KMDE-10/ghra/hardware/images/WhatsApp Image 2026-03-20 at 16.06.54 (3).jpeg

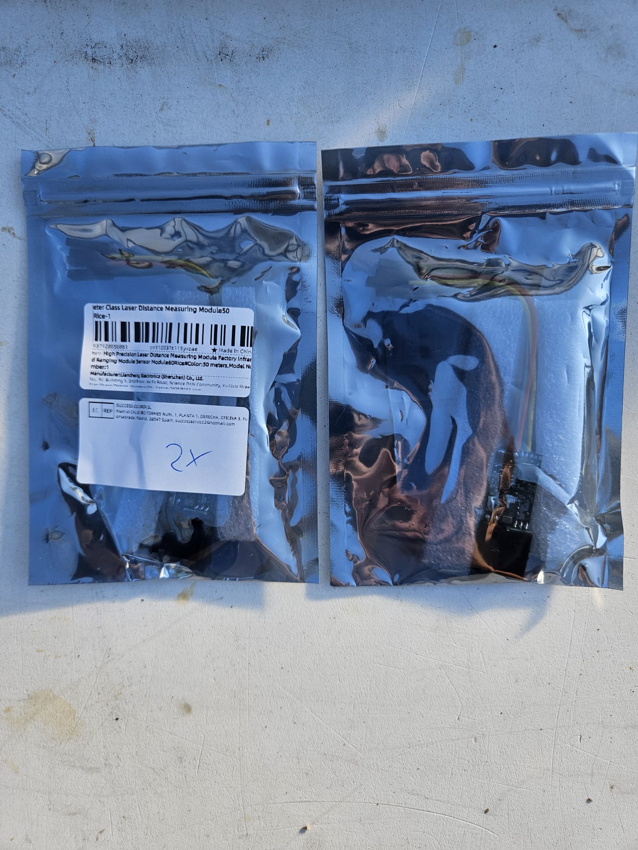
hardware/images/WhatsApp Image 2026-03-20 at 16.06.54 (3).jpeg
