KMDE-10/ghra/hardware/inverter/WhatsApp Image 2026-03-28 at 12.23.41(1).jpeg

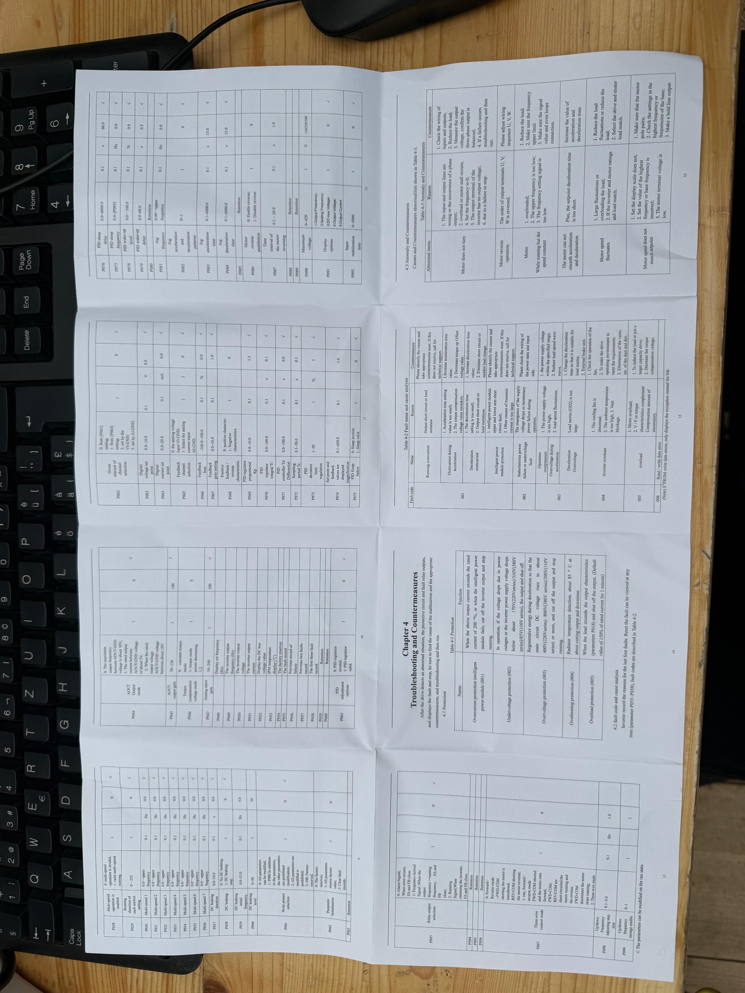
hardware/inverter/WhatsApp Image 2026-03-28 at 12.23.41(1).jpeg
