KMDE-10/ghra/hardware/20260308_Budget-Suspension Structure - Budget 09.03.2026.csv

Item | Link | Quantity | Cost w/o VAT | Supplier | Transportation fee | Total cost w/o VAT | 2458.29
Motorized Trolley | https://www.crossfer.de/TD10A-Elektrische-Laufkatze-230V-1000KG-Last-inkl | 1 | €142.02 | https://www.crossfer.de/ | 20 | €162.02
IPE 140 (I-Beam with 13.2 kg/m) | https://b2b.neuberg.lu/de/artikel/stahl,4405,ipe-1406100-s235jr,140333/?search_keywords=ipe+140 | 18 | €20.56 | Neuberg (Lux) | 100 | €470.00
Wiltec Trolley up to 500 kg | https://www.amazon.de/-/en/VEVOR-Trolley-Capacity-Adjustable-Straight/dp/B0D3DD9J57 | 5 | €21.17 | Amazon | 10 | €115.85
Rust protection Paint | https://www.amazon.de/dp/B0FBMKLGBH?th=1 | 1 | €116.39 | Amazon | 10 | €126.39
Aluminium Profile | MOTEDIS |  |  |  |  | €0.00
Fixture for IPE to GH truss | https://www.amazon.de/-/en/gp/product/B0F9PNK55S | 6 | €13.99 | Amazon | 10 | €93.94
Rubber Cable 220V - 1,5mm2 30 m | https://www.amazon.de/-/en/EMOS-extension-waterproof-temperature-insulation/dp/B014WKRMC2 | 1 | €67.00 | Amazon | 10 | €77.00
Hutschienensicherung 16 A |  | 2
Frequency invertor | https://www.amazon.de/-/en/Frequency-Inverter-Controller-Efficient-Performance/dp/B0CCF3Q1CT/ | 1 | €42.96 | Amazon | 10 | €52.96
Hutschiene | 1.5 m
Konrad Service |  | 12 | €75.00 |  |  | €900.00
Konrad Material |  | 1 | €200.00 |  |  | €200.00
Tools for painting |  | 1 | €50.00
Degreaser / Thinner |  |  | €20.00
Cable Box(es) |  |  | €50.00
 |  |  |  |  |  |  | €260.13 | Setup:
Ethernet Cable | https://www.aliexpress.com/item/1005010138635011.html?mp=1 | 2 | €16.00 | Aliexpress |  | €32.00 |  | ROS Core on Dell Optiplex
Throughhole Cable Fittings | https://www.aliexpress.com/item/1005010449732226.html?mp=1 | 2 | €2.50 | Aliexpress |  | €5.00 |  | Switch next to Dell
Relais Rail Mount 5V | https://www.aliexpress.com/item/1005004552509292.html?mp=1 | 4 | €3.19 | Aliexpress |  | €12.76 |  | Controlbox on Laufkatze
W5500 Ethernet Module for ESP32 | https://www.aliexpress.com/item/1005008385092801.html?mp=1 | 5 | €4.00 | Aliexpress |  | €20.00 |  |  | ESP for Inverter control??
Red LED Pushbutton for manual override | https://www.aliexpress.com/item/1005007935799554.html?mp=1 | 2 | €3.89 | Aliexpress |  | €7.78 |  |  | Two Relais
Green LED Pushbutton for manual override | https://www.aliexpress.com/item/1005007935799554.html?mp=1 | 2 | €3.89 | Aliexpress |  | €7.78 |  |  | Two Schütze (Circuit Controllers) 24v
Hutschienen Netzteil für ESP32 5V | https://www.aliexpress.com/item/1005010515354755.html?mp=1 | 5 | €5.19 | Aliexpress |  | €25.95 |  |  | Power supply 5v for ESP
Hutschienen Netzteil für Schütz 24V | https://www.aliexpress.com/item/1005010515354755.html?mp=1 | 3 | €5.19 | Aliexpress |  | €15.57 |  |  | Power supply 24v for Schütz
ESP32 Plus Kit | https://www.aliexpress.com/item/1005007820190456.html?mp=1 | 4 | €6.49 | Aliexpress |  | €25.96 |  |  | W5500 Module für Network
Laser Distance | https://www.aliexpress.com/item/1005009250844924.html?mp=1 | 2 | €20.77 | Aliexpress | €6.00 | €41.54 |  |  | RJ45 Port
Box for Control large | https://de.aliexpress.com/item/1005005480970197.html?curPageLogUid=Wb5HhpVQlF6D | 2 | €11.29 | Aliexpress |  | €22.58 |  |  | Power input via Cable Through hole
Box for sensor small | https://www.aliexpress.com/item/1005005480970197.html?mp=1 | 4 | €4.89 | Aliexpress |  | €19.56
Ethernet Ports for Sensor Boxes | https://www.aliexpress.com/item/1005009884563859.html?mp=1 | 4 | €3.79 | Aliexpress |  | €15.16
Terminal Blocks | https://de.aliexpress.com/item/1005004501344762.html?curPageLogUid=UBmoCmYr6PxX | 1 | €8.49 | Aliexpress |  | €8.49 |  | Controlbox für Verfahren mit Rot oder Grünen buttons
 |  |  |  |  |  |  |  |  | Manual buttons
 |  |  |  |  |  |  |  |  | ESP
 |  |  |  |  |  |  |  |  | W5500
 |  |  |  |  |  |  |  |  | Network
 |  |  |  |  |  |  |  |  | RJ45 Port
 |  |  |  |  |  |  |  |  | Power supply
 |  |  |  |  |  |  |  |  | Power input
 |  |  |  |  |  |  |  |  | SicherungsKasten für den Motor?
 |  |  |  |  |  |  |  | Ethernet Kabel zur Laufkatze
 |  |  |  |  |  |  |  | Stromkabel zur Laufkatze
 |  |  |  |  |  |  |  | Controlbox für Laser Sensor Unit
 |  |  |  |  |  |  |  |  | Sensor Module
 |  |  |  |  |  |  |  |  | ESP
 |  |  |  |  |  |  |  |  | W5500
 |  |  |  |  |  |  |  |  | Network
 |  |  |  |  |  |  |  |  | RJ45 Port
 |  |  |  |  |  |  |  |  | Power supply
 |  |  |  |  |  |  |  |  | Power input
 |  |  |  |  |  |  |  |  | Sicherung
