KMDE-10/ghra/(commit log)

2026-03-24 Add ROS2 motor control system: Docker infrastructure, ESP32 firmware, and web dashboard
    - Docker Compose (Podman-compatible) with micro-ROS agent, ROS2 core + rosbridge, Vue.js dashboard
    - ESP32 motor controller: W5500 Ethernet, GP8211S DAC (0-10V to VFD), laser distance sensor (UART), FWD/REV relays
    - ESP32 remote controller: WiFi, 4-button (fwd fast/slow, bwd slow/fast) with micro-ROS
    - ROS2 control node: button-to-speed mapping with position safety limits
    - Vue.js dashboard: speed slider, direction control, live position display
    - Hardware BOM and reference images
    [20260308_Budget-Suspension Structure - Budget 09.03.2026.csv]
2026-03-24 Add system plan documentation with hardware specs, wiring details, and software architecture
2026-03-25 Update firmware for new ESP32 network API, add wiring diagrams, remap dashboard port
    - esp32-motor: switch to NetworkInterface/ETH.begin v2 API, add board ID pin (GPIO32),
    fix DAC constructor, use custom UDP transport for micro-ROS over Ethernet
    - esp32-remote: simplify micro-ROS WiFi transport setup with char arrays
    - docker-compose: remap web dashboard from port 443 to 8443
    - Add SVG wiring diagrams for motor and remote ESP32 boards
    [esp32-motor.ino, esp32-remote.ino]
2026-03-28 worked on inverter and laser
2026-03-28 saftey before welding
2026-05-05 gitignore credential-bearing helper scripts
    Safety commit before refactoring start.sh.
    .dell_ssh.py and .tmp_probe.sh both hardcode the Dell SSH password,
    so they must never reach the remote.
2026-05-05 make start.sh idempotent and offline-safe
    Default invocation no longer tears down the running stack or runs
    podman-compose build, so it works on systemd boot without internet
    and is safe to re-run on a healthy stack (no-op).
    Use --rebuild to opt into the heavy path (down + build + up); that
    still requires internet and is meant to be run manually after code
    changes, not from systemd.
    Also fixes the printed dashboard URL from https:// to http:// to
    match what nginx actually serves on port 8443, and adds health
    probes for the MQTT-WS (9001) and ROSbridge (9090) ports.
